sergeskynet-byte/PoolTimer/Autocollants.png

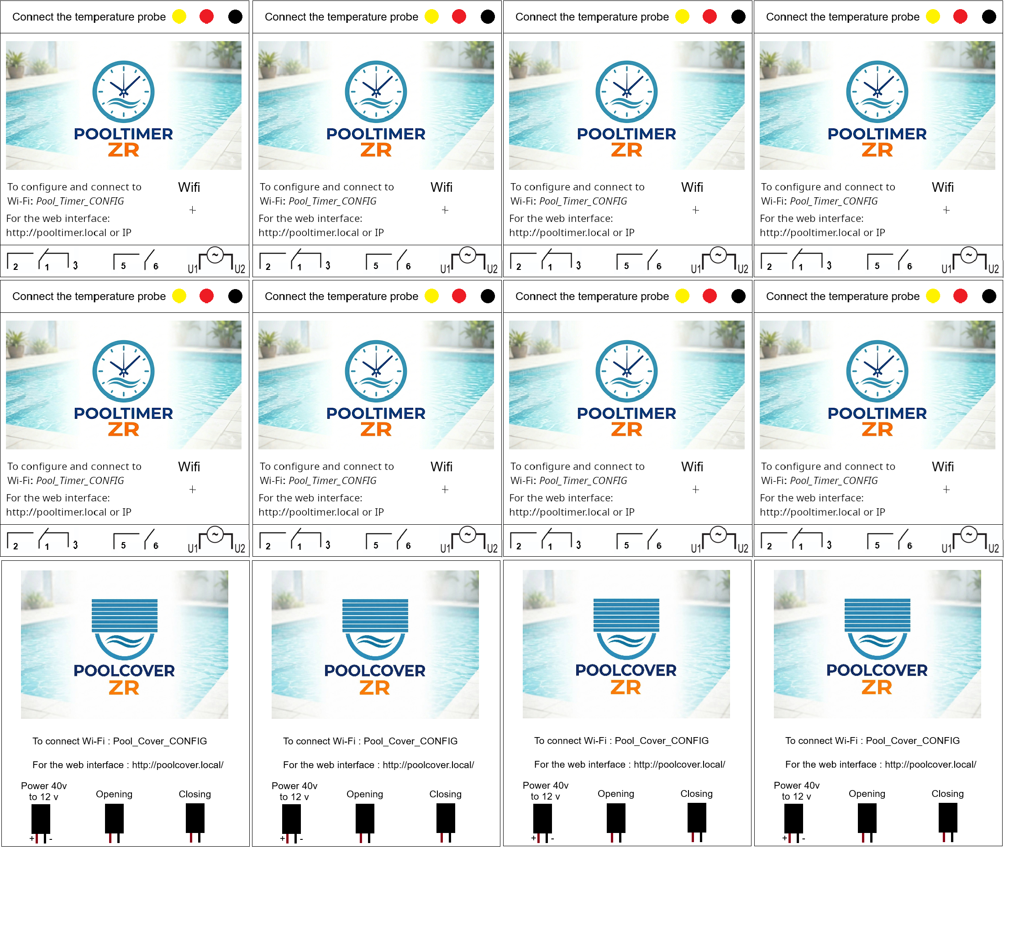
Autocollants.png
