sergeskynet-byte/PoolTimer/Liste_pièces.xlsx

Désignations | Quantité | Liens | Prix unitaire
Aimentation HLK-PM01 (5V 3W) | 1 | https://fr.aliexpress.com/item/1005009959812212.html | 3.59
ESP32-C3 SuperMini ESP32 ESP32-C3FH4 | 1 | https://fr.aliexpress.com/item/1005009650444649.html | 2.89
Porte sonde hermowell 304 en acier inoxydable 304, filetage 1/2 G 30mm | 1 | https://fr.aliexpress.com/item/1005009393030295.html | 3.59
Relais Relais SRD-05VDC-SL | 2 | https://fr.aliexpress.com/item/1005008747109128.html | 2.28
Led 5V 5mm | 1 | https://fr.aliexpress.com/item/1005006096090294.html | 2.61
1 Fusible 1A + support 1808 1A | 1 | https://fr.aliexpress.com/item/1005004210486564.html | 4.69
Resisances 4,7Kohm, 220ohm | 2 | https://fr.aliexpress.com/item/1005009340139498.html | 1.03
Boitier DIN 53,3mm AK-DR-103 | 1 | https://fr.aliexpress.com/item/1005006067012648.html?curPageLogUid=Ek7L2NbJOS6M | 2.18
Support LED 5mm (facultatif) | 1
Varistance s07k275 | 1 | https://fr.aliexpress.com/item/1005005959395114.html?curPageLogUid=Iamijfu4KuRm | 2.18
Isolation optique PC817 | 2 | https://fr.aliexpress.com/item/1005010374518123.html | 2.95
Transistor 2N3904 | 2 | https://fr.aliexpress.com/item/1005007205386825.html?curPageLogUid=6jf20STaiBcK | 1.32
Diode 1N4007 | 2 | https://fr.aliexpress.com/item/1005009923993443.html | 1.42
PCB bornier connecteur pas 5.0mm KF301 broche droite 2P | 1 | https://fr.aliexpress.com/item/1005007055503766.html | 1.71
PCB bornier connecteur pas 5.0mm KF301 broche droite 3P | 2 | https://fr.aliexpress.com/item/1005007055503766.html | 1.71
Capteur temperature DS18B20 3m ou plus | 1 | https://fr.aliexpress.com/item/1005006090368473.html | 1.92
PCB avec fichier Gerber | 1 | https://jlcpcb.com/ | 4.16
Collier de prise en charge de sonde au diamètre des tuyaux | 1
Total : |  |  | 40.23
