sergeskynet-byte/PoolTimer/Schéma.pdf

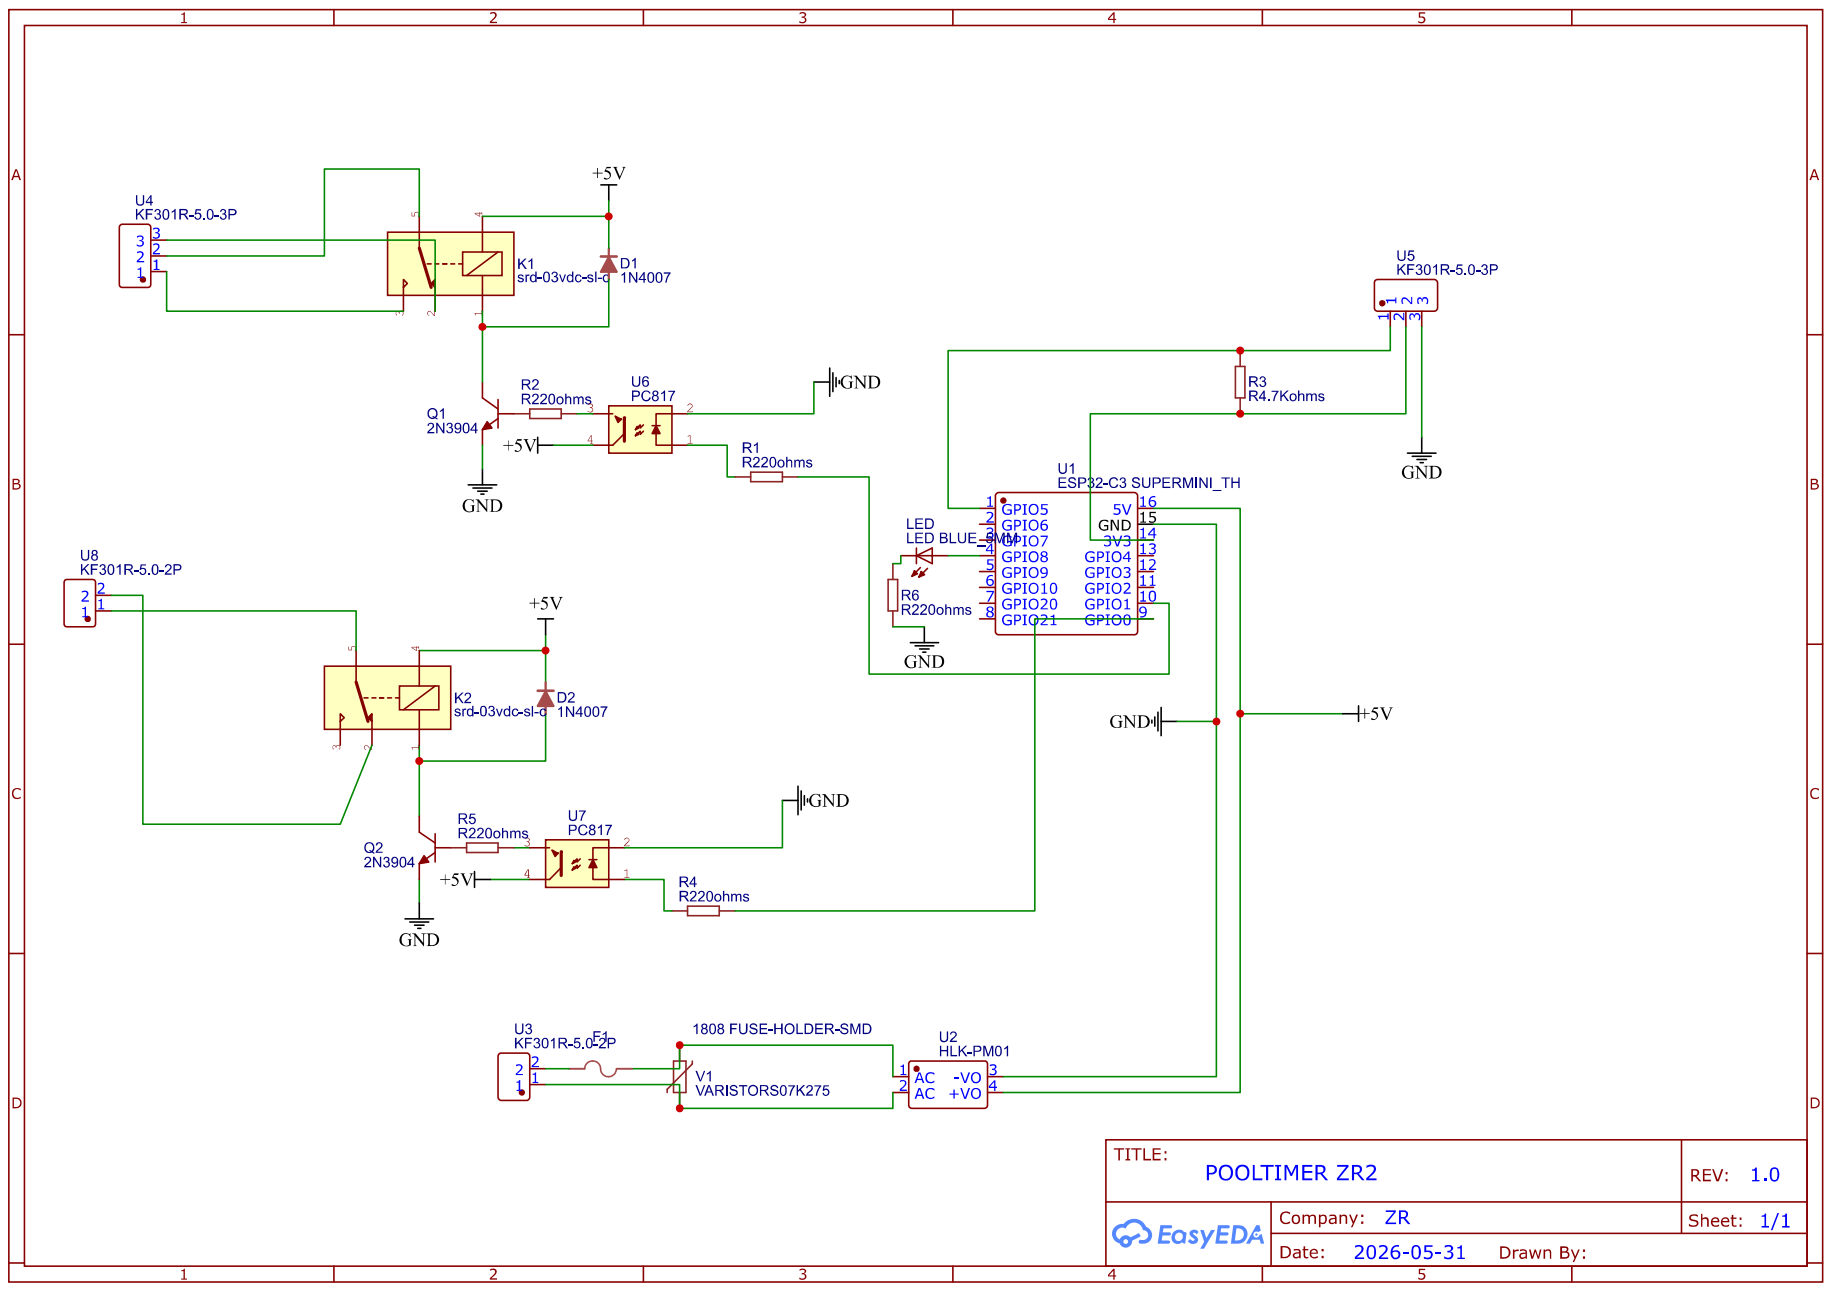
[picture p8: page 1]
